LjungrennAudio/ryomodular.com_vc-seq/README.md

# ryomodular.com_vc-seq
 yup - here he is, he's got his own repo! it's the vc-seq!

240901254

mostly just a repo to hold the documentation relating to this module by ro modular.
