LjungrennAudio/ryomodular.com_vc-seq/docs/RYO_VC-Seq_Spec_Sheet.pdf

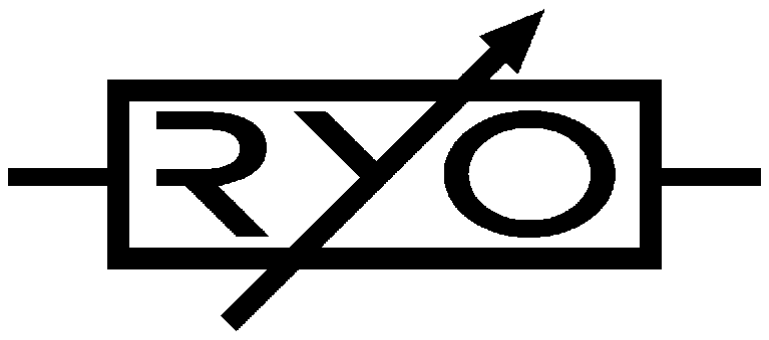
[picture p3: figure]

LjunggrenAudio RYO VC Sequencer: Compact 8-step Voltage Controlled Sequencer

Dimensions
Height: | 3U (128.5mm)
Width: | 10HP (50.50mm)
Depth: | 42mm (with power cable attached)
Weight: | 125g (approx w/cable)

Current consumption
+12V rail | 22mA (version 1.2 28mA)
-12V rail | 11mA
+5V rail | no +5V supply required

Basic specifications
total frequency controllable range | dc to 100+ kHz
max input signal | 0V to +10V
max output signal/audio signal | 10Vpp (-5V to +5V)
Max gain: | n/a

Nominal impedances
Audio signal input: | 100k ohm
Audio Signal output: | in loop compensated
CV input: | n/a
