LjungrennAudio/ryomodular.com_vc-seq/docs/vc seq pcb 1 schematic.png

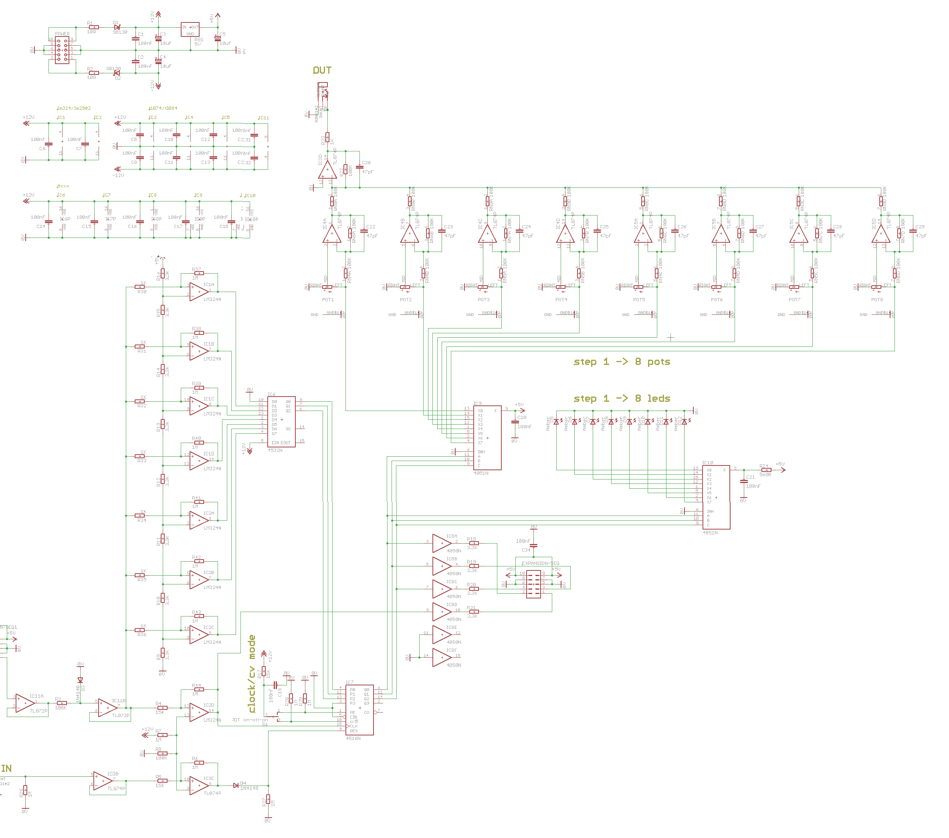
docs/vc seq pcb 1 schematic.png
