LjungrennAudio/ryomodular.com_vc-seq/docs/vc seq pcb 2 schematic.png

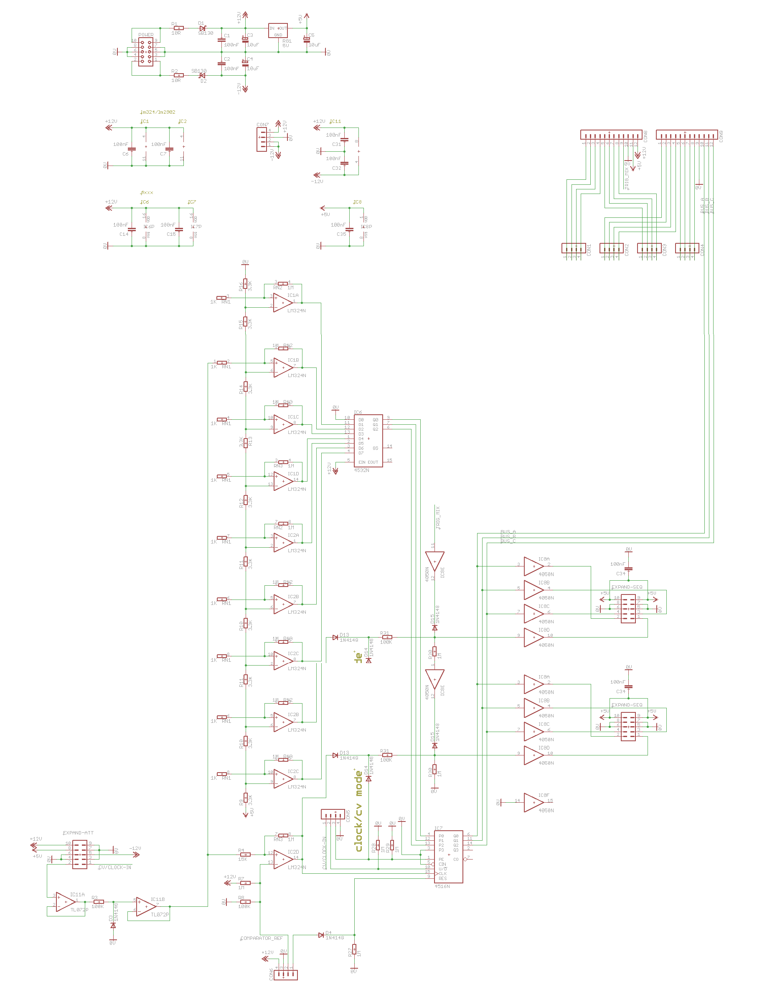
docs/vc seq pcb 2 schematic.png
