LjungrennAudio/ryomodular.com_vc-seq/docs/vc seq pcb 3 schematic.png

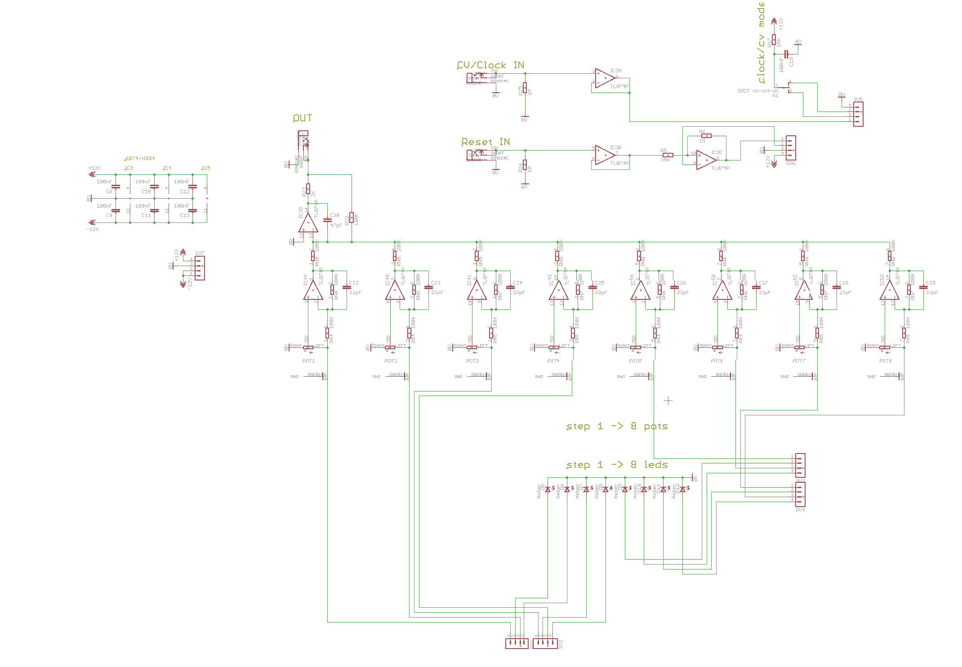
docs/vc seq pcb 3 schematic.png
