LjungrennAudio/ryomodular.com_vc-seq/docs/VC Sequencer 1.5 Schematic.gif

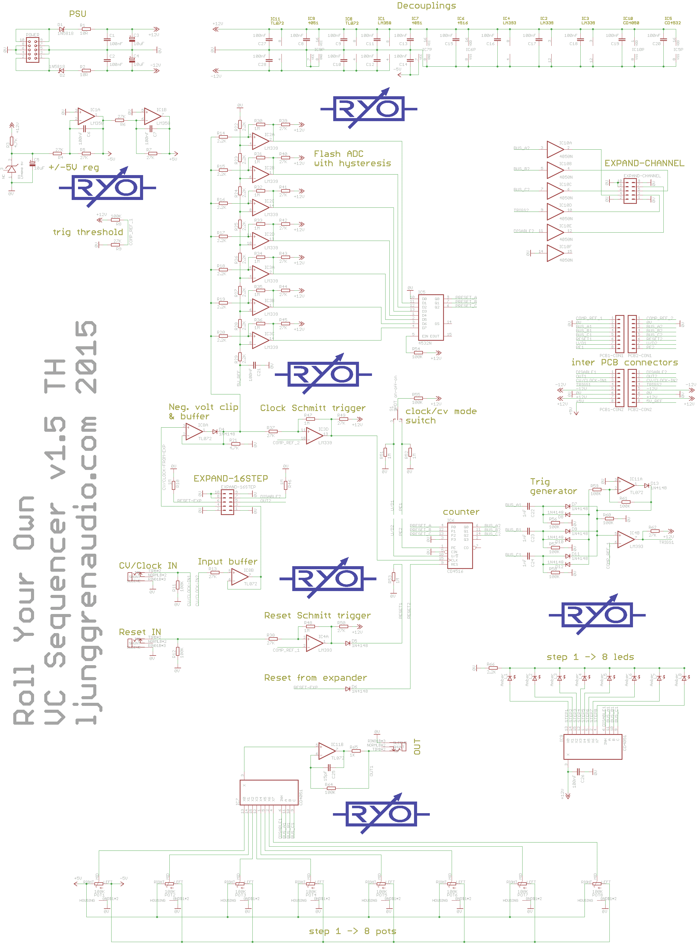
docs/VC Sequencer 1.5 Schematic.gif
