LjungrennAudio/ryomodular.com_vc-seq/docs/RYO_VC-Seq_Assembly_Guide.pdf

# Ljunggren Audio Roll Your Own

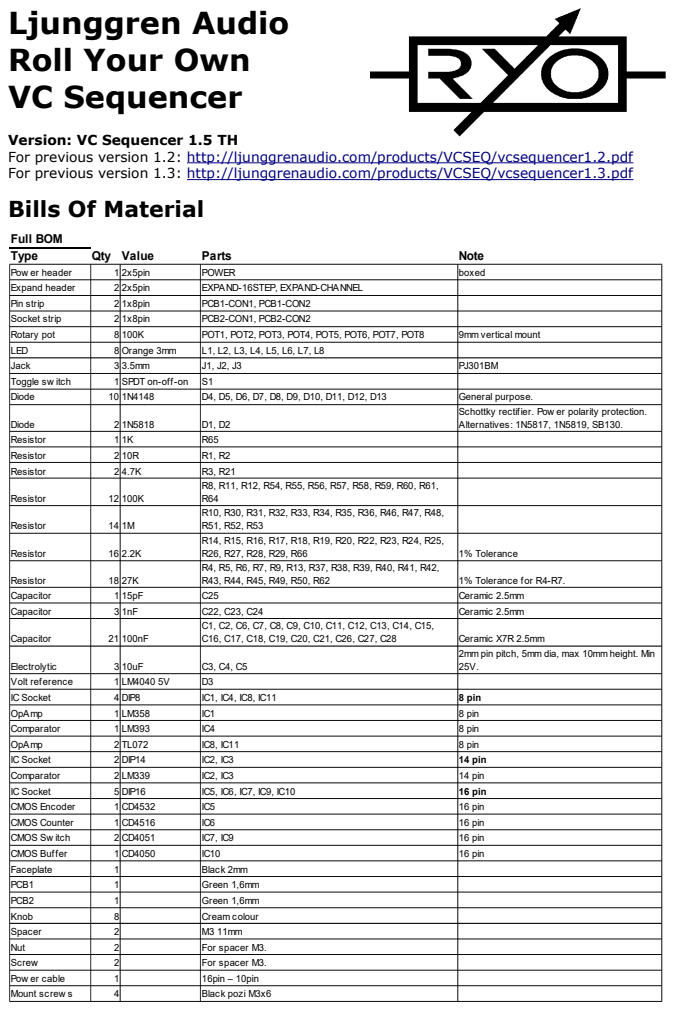
[picture p8: page 1]

Version: VC Sequencer 1.5 TH
For previous version 1.2: http://ljunggrenaudio.com/products/VCSEQ/vcsequencer1.2.pdf
For previous version 1.3: http://ljunggrenaudio.com/products/VCSEQ/vcsequencer1.3.pdf
Bills Of Material

Schottky rectifier. Pow er polarity protection.
Alternatives: 1N5817, 1N5819, SB130.

2mm pin pitch, 5mm dia, max 10mm height. Min

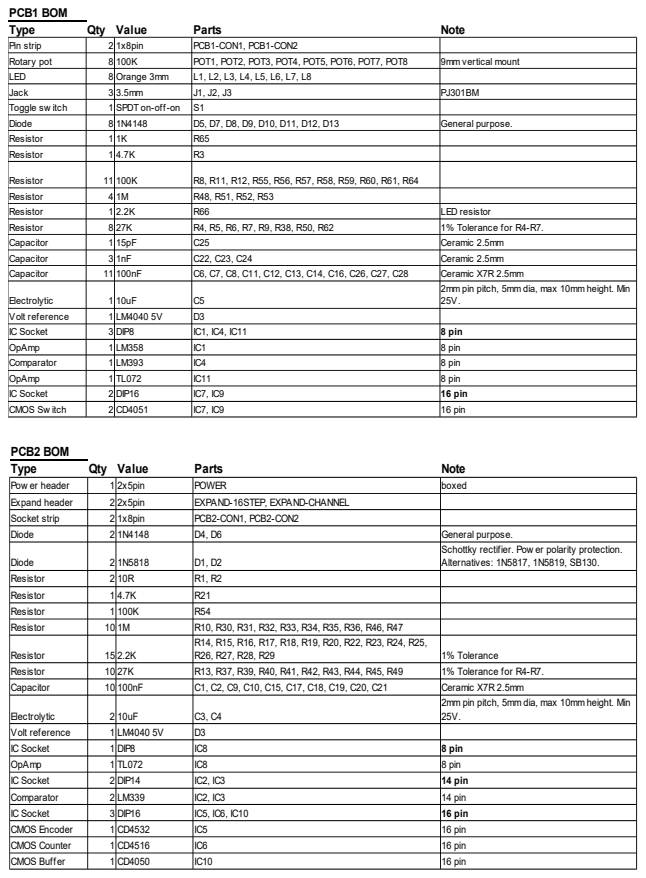
[picture p9: page 2]

2mm pin pitch, 5mm dia, max 10mm height. Min

Schottky rectifier. Pow er polarity protection.
Alternatives: 1N5817, 1N5819, SB130.

## Assembly instructions

We start with PCB2.

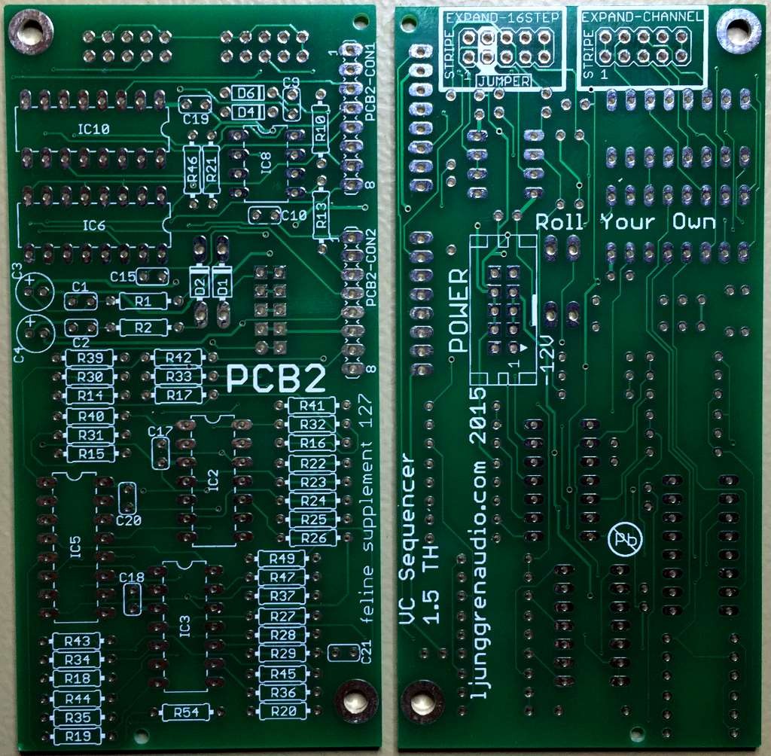
[picture p10: figure]

Empty PCB2 top & bottom.

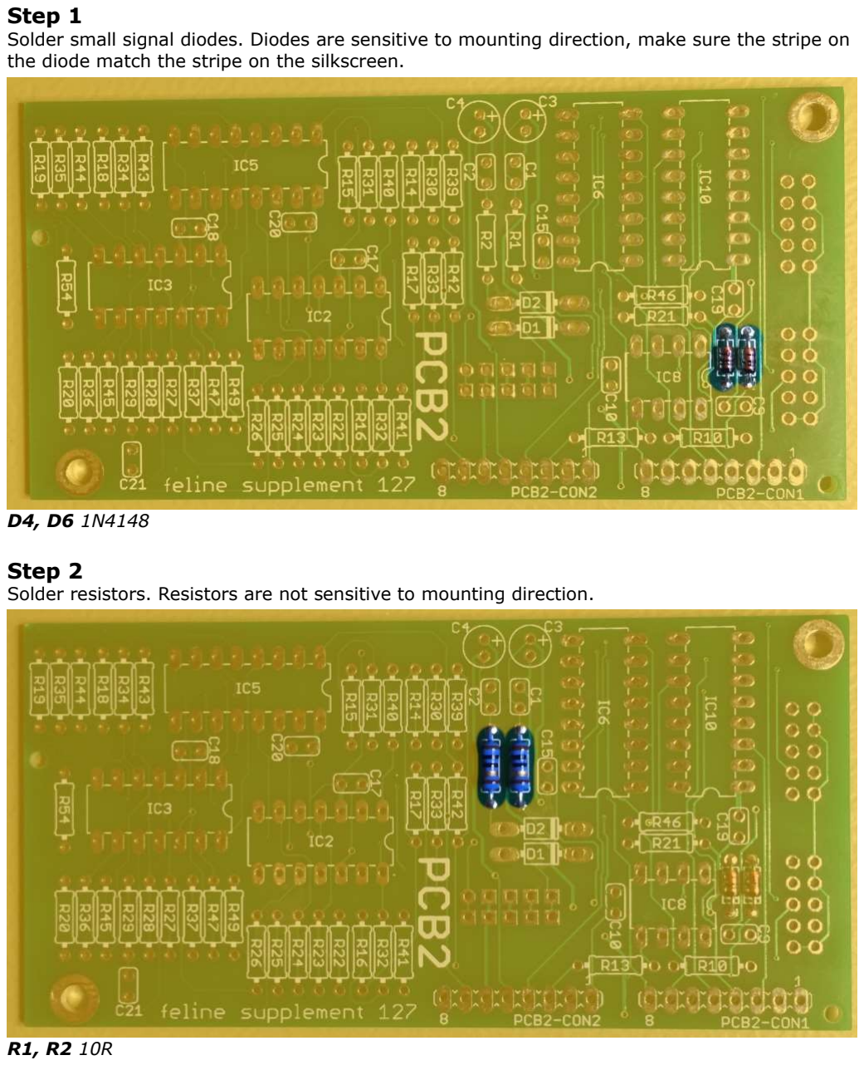
[picture p11: page 4]

### Step 1

Solder small signal diodes. Diodes are sensitive to mounting direction, make sure the stripe on the diode match the stripe on the silkscreen.

D4, D6 1N4148

### Step 2

Solder resistors. Resistors are not sensitive to mounting direction.

R1, R2 10R

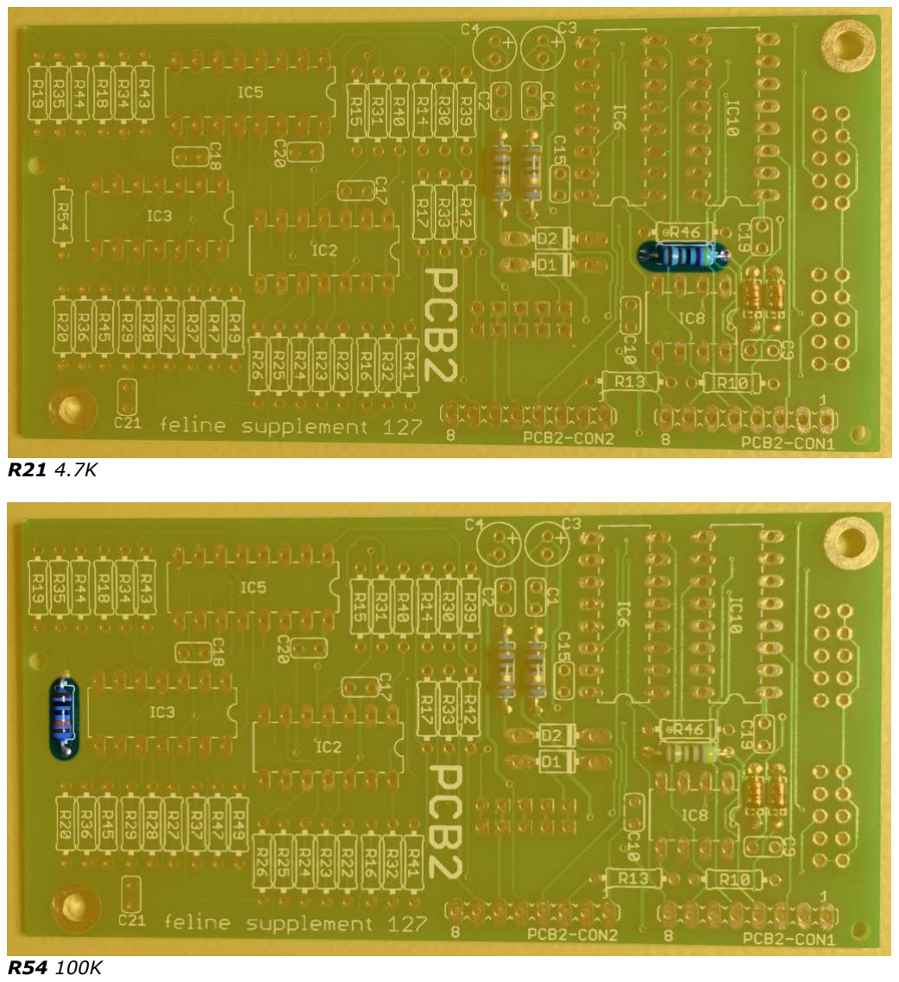
[picture p12: page 5]

R21 4.7K

R54 100K

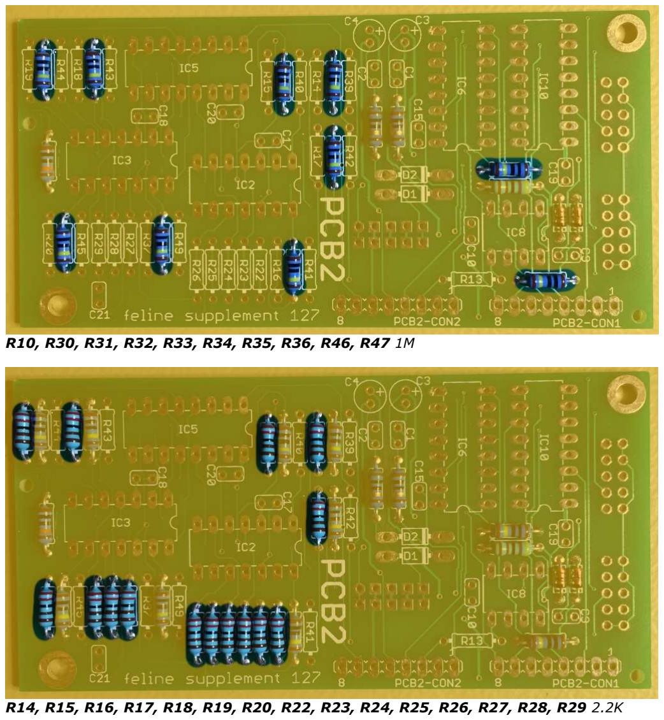
[picture p13: page 6]

R10, R30, R31, R32, R33, R34, R35, R36, R46, R47 1M

R14, R15, R16, R17, R18, R19, R20, R22, R23, R24, R25, R26, R27, R28, R29 2.2K

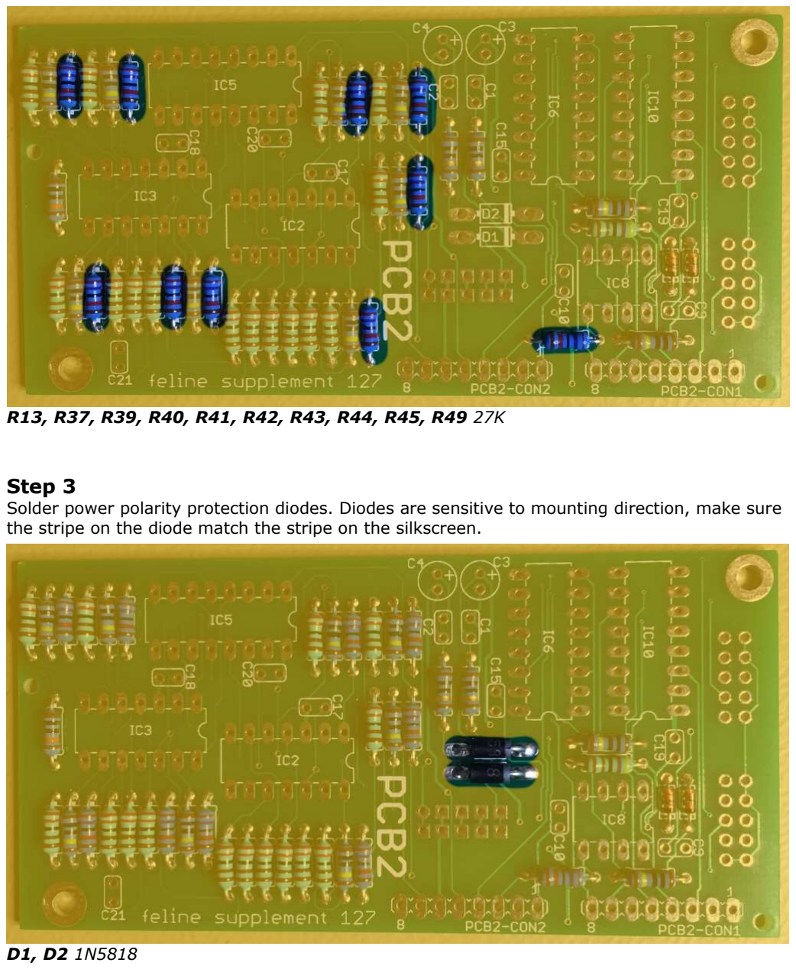
[picture p14: page 7]

R13, R37, R39, R40, R41, R42, R43, R44, R45, R49 27K

### Step 3

Solder power polarity protection diodes. Diodes are sensitive to mounting direction, make sure the stripe on the diode match the stripe on the silkscreen.

D1, D2 1N5818

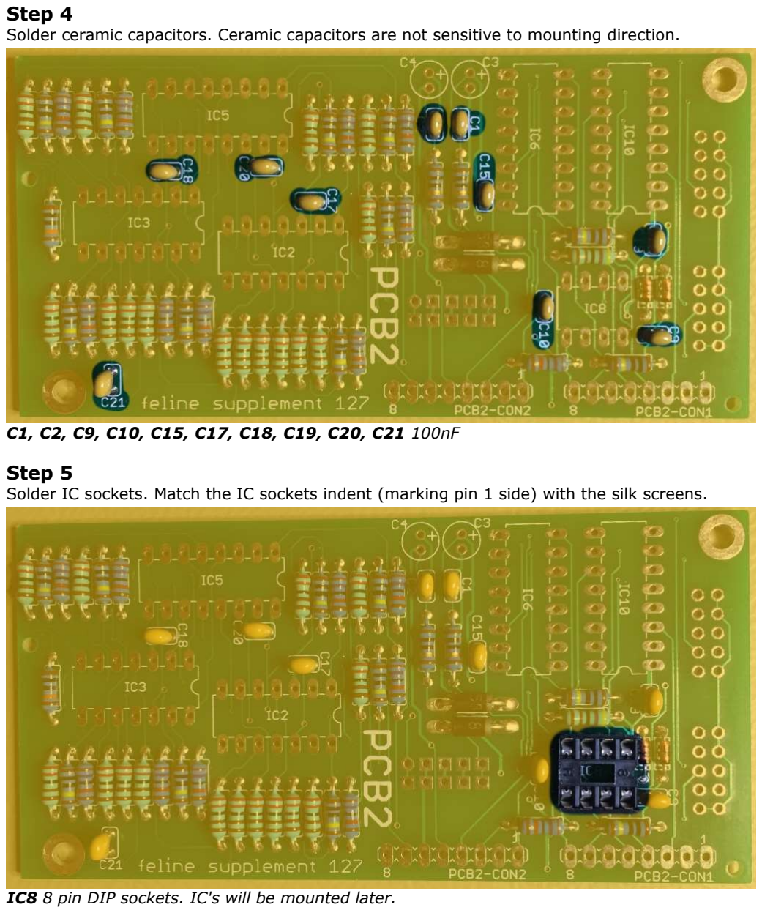
[picture p15: page 8]

### Step 4

Solder ceramic capacitors. Ceramic capacitors are not sensitive to mounting direction.

C1, C2, C9, C10, C15, C17, C18, C19, C20, C21 100nF

### Step 5

Solder IC sockets. Match the IC sockets indent (marking pin 1 side) with the silk screens.

IC8 8 pin DIP sockets. IC's will be mounted later.

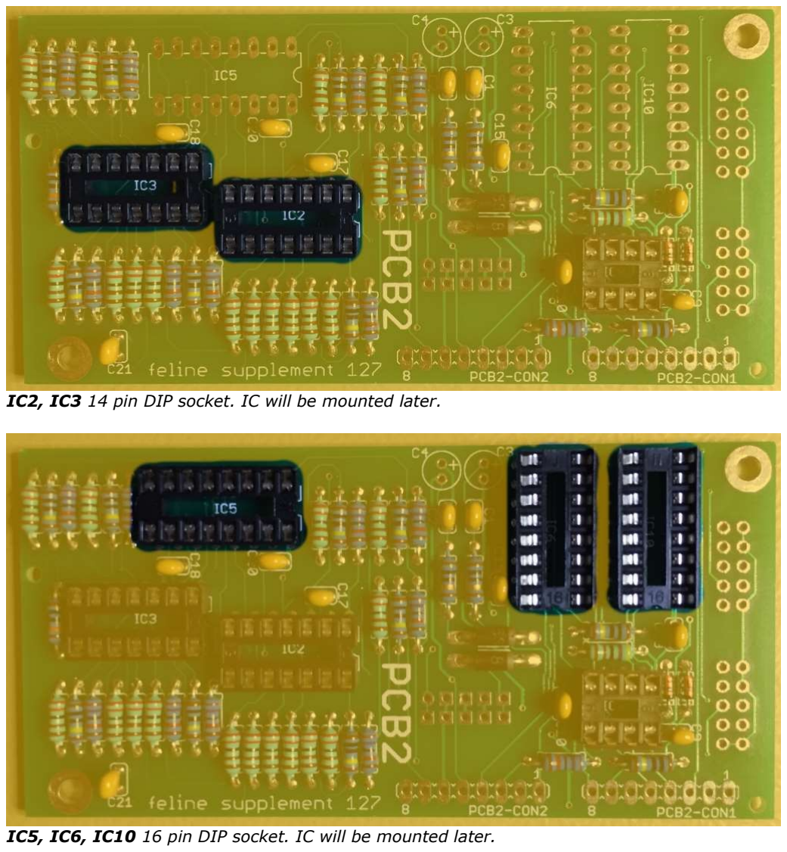
[picture p16: page 9]

IC2, IC3 14 pin DIP socket. IC will be mounted later.

IC5, IC6, IC10 16 pin DIP socket. IC will be mounted later.

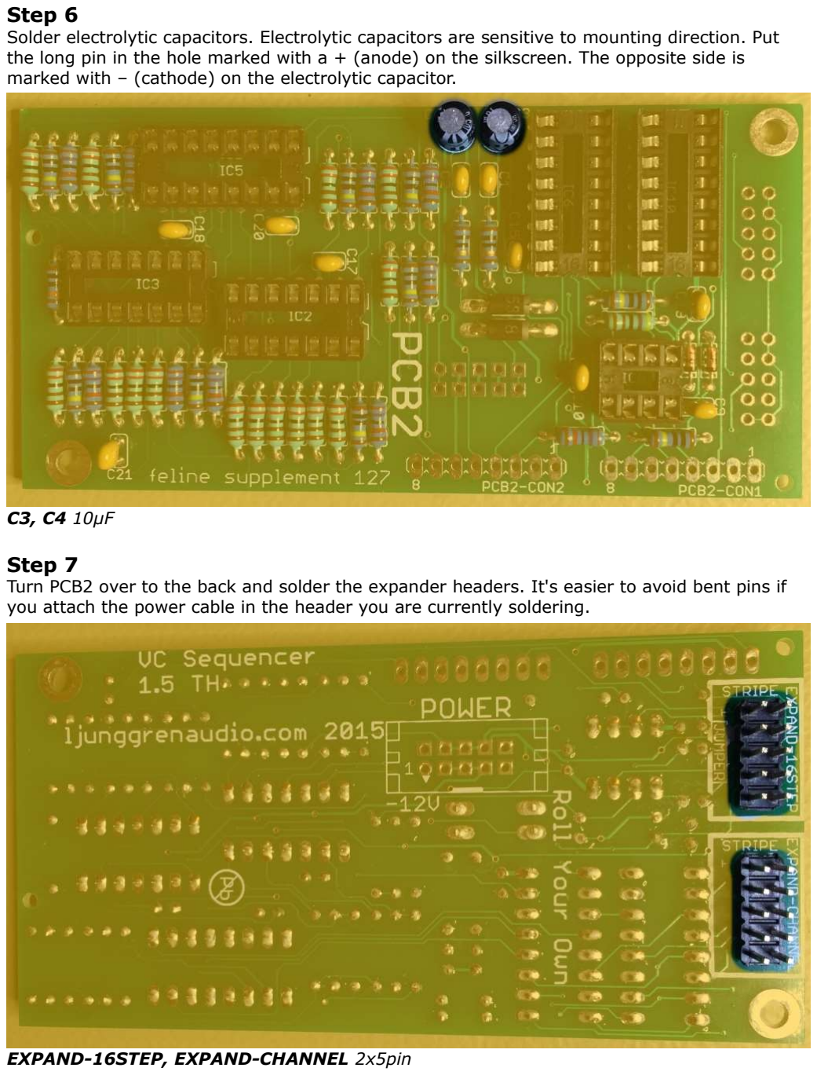
[picture p17: page 10]

### Step 6

Solder electrolytic capacitors. Electrolytic capacitors are sensitive to mounting direction. Put the long pin in the hole marked with a + (anode) on the silkscreen. The opposite side is marked with – (cathode) on the electrolytic capacitor.

C3, C4 10µF

### Step 7

Turn PCB2 over to the back and solder the expander headers. It's easier to avoid bent pins if you attach the power cable in the header you are currently soldering.

EXPAND-16STEP, EXPAND-CHANNEL 2x5pin

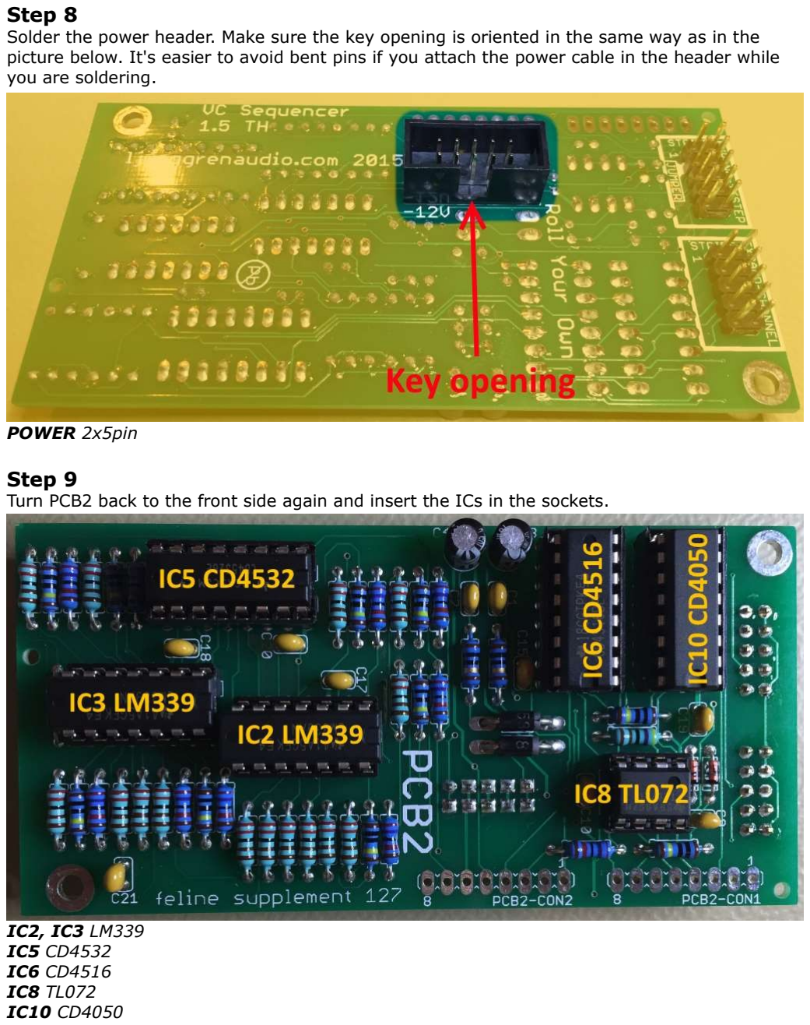
[picture p18: page 11]

### Step 8

Solder the power header. Make sure the key opening is oriented in the same way as in the picture below. It's easier to avoid bent pins if you attach the power cable in the header while you are soldering.

POWER 2x5pin

### Step 9

Turn PCB2 back to the front side again and insert the ICs in the sockets.

IC2, IC3 LM339
IC5 CD4532
IC6 CD4516
IC8 TL072
IC10 CD4050

### Step 10

Leave PCB2 on the side with PCB2-CON1 and PCB2-CON2 not soldered. Now it's time for PCB1.

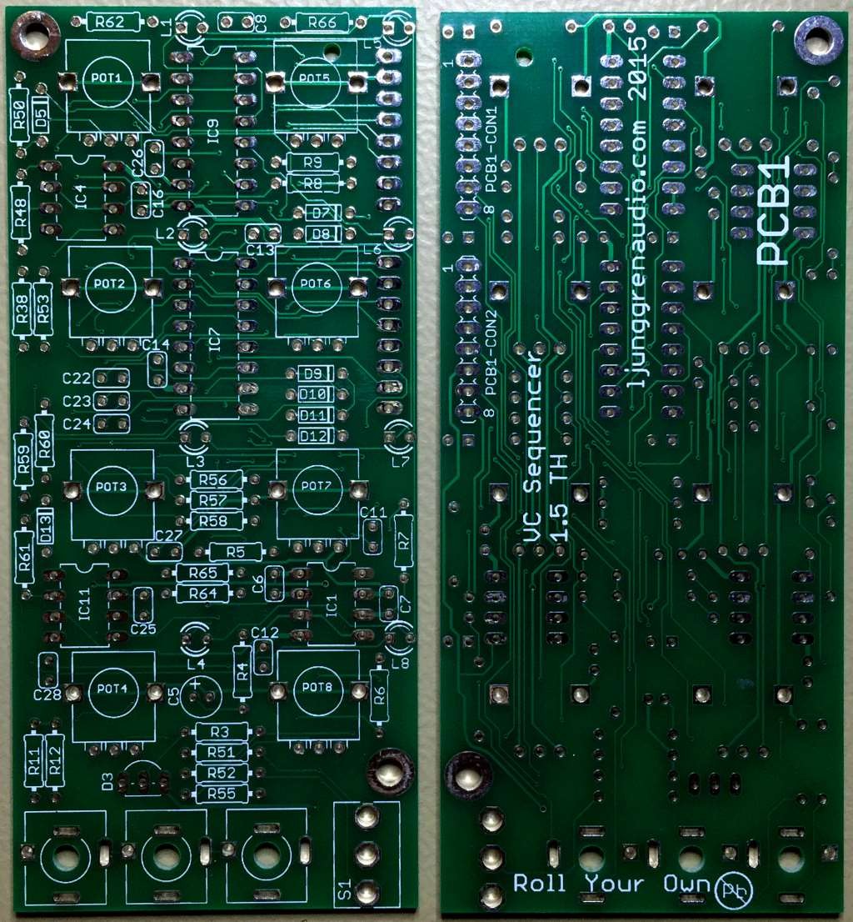
[picture p19: figure]

Empty PCB1 top & bottom.

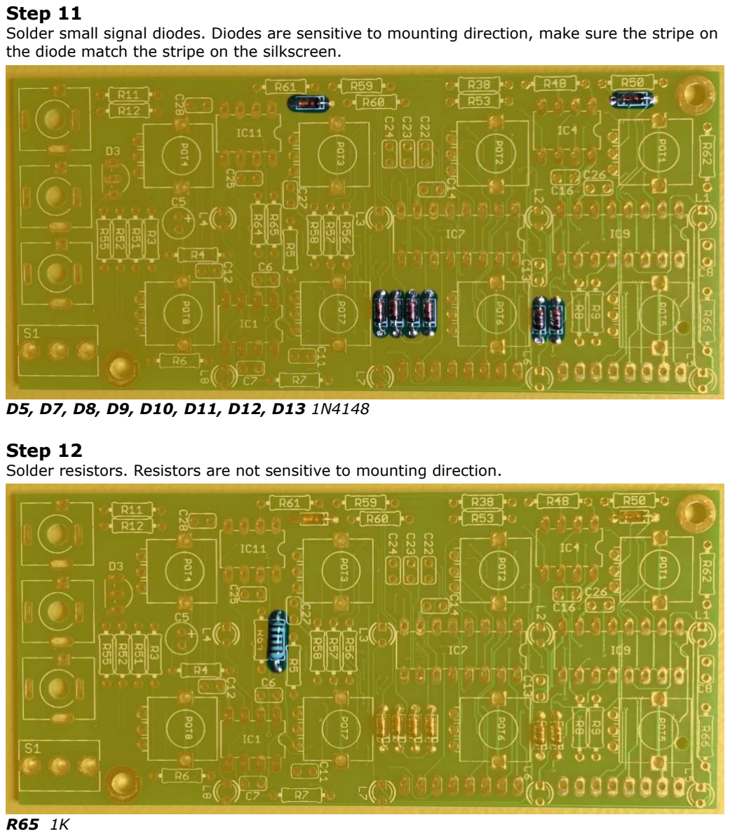
[picture p20: page 13]

### Step 11

Solder small signal diodes. Diodes are sensitive to mounting direction, make sure the stripe on the diode match the stripe on the silkscreen.

D5, D7, D8, D9, D10, D11, D12, D13 1N4148

### Step 12

Solder resistors. Resistors are not sensitive to mounting direction.

R65 1K

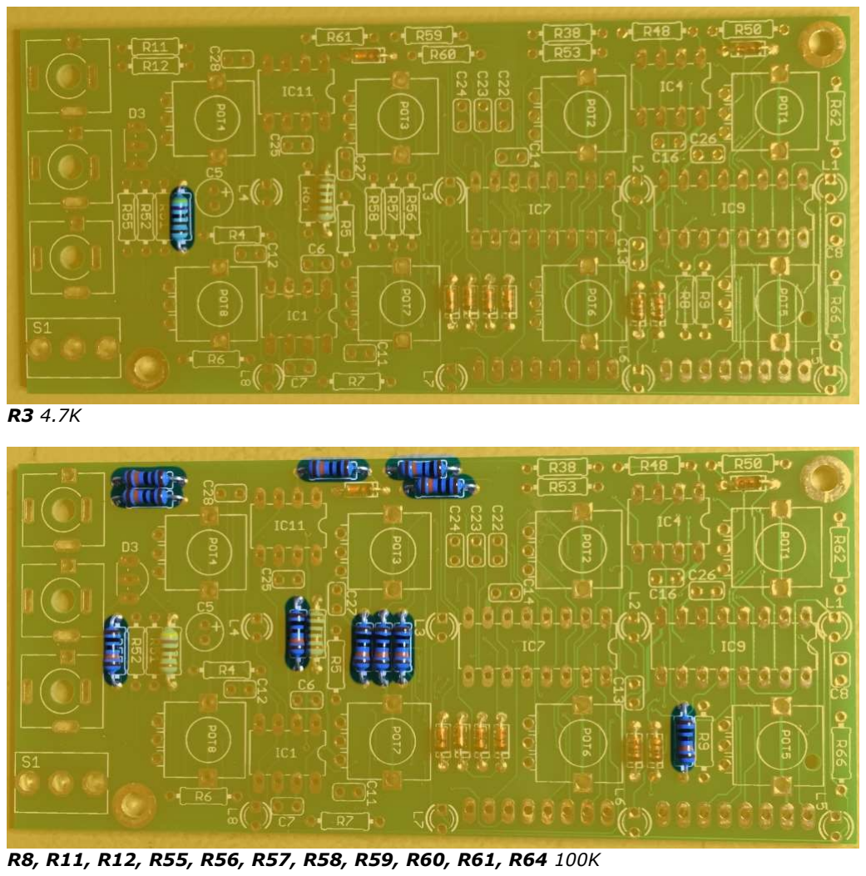
[picture p21: page 14]

R3 4.7K

R8, R11, R12, R55, R56, R57, R58, R59, R60, R61, R64 100K

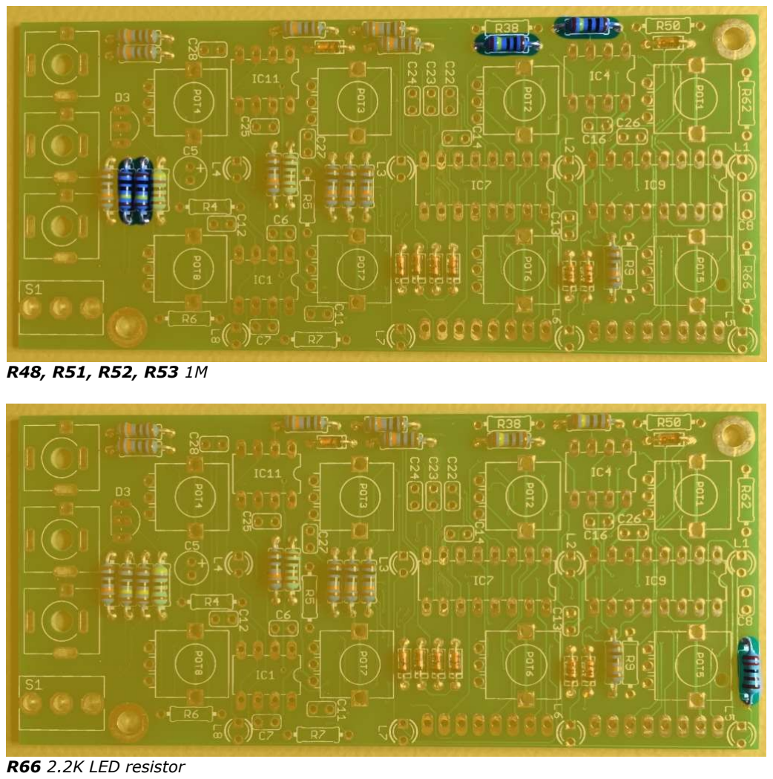
[picture p22: page 15]

R48, R51, R52, R53 1M

R66 2.2K LED resistor

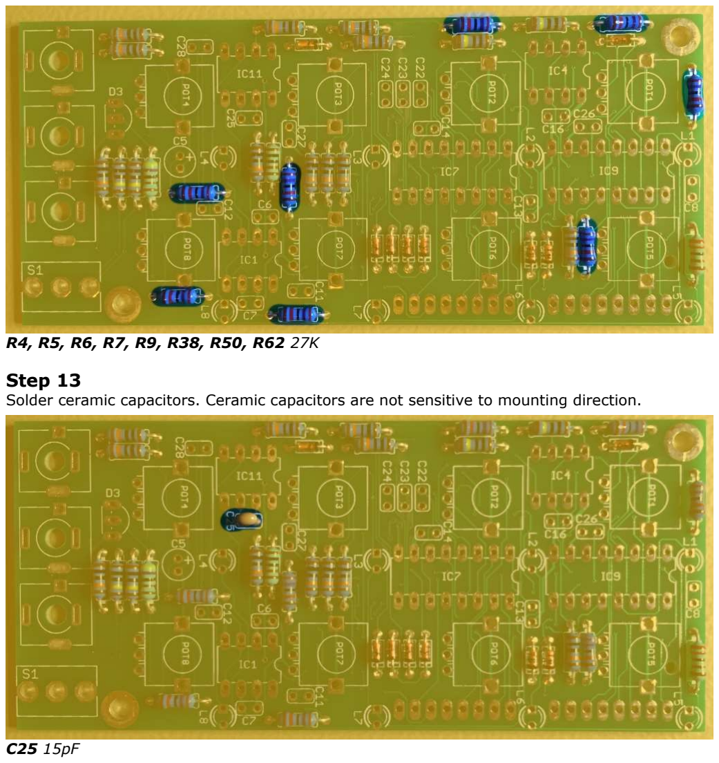
[picture p23: page 16]

R4, R5, R6, R7, R9, R38, R50, R62 27K

### Step 13

Solder ceramic capacitors. Ceramic capacitors are not sensitive to mounting direction.

C25 15pF

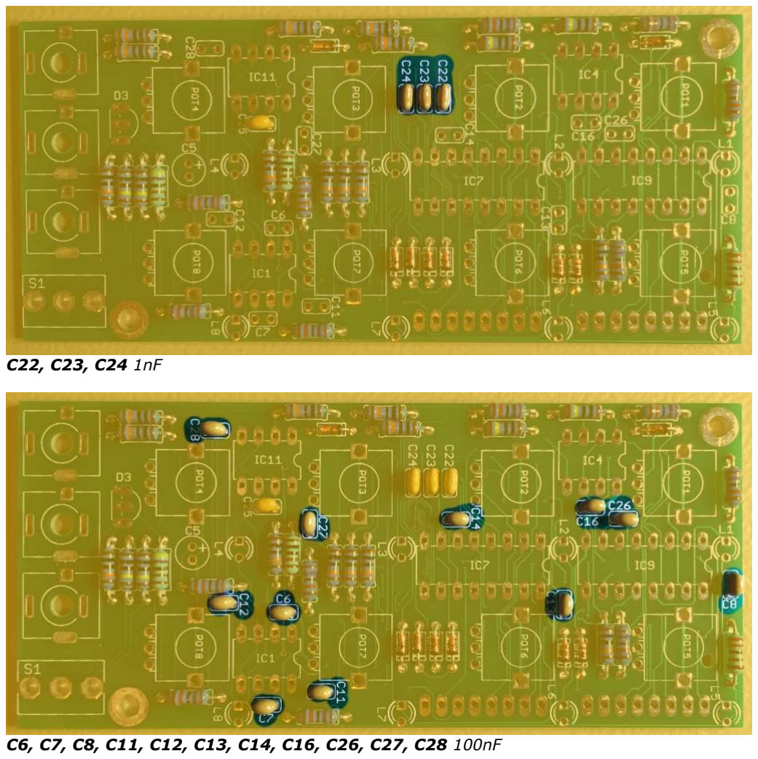
[picture p24: page 17]

C22, C23, C24 1nF

C6, C7, C8, C11, C12, C13, C14, C16, C26, C27, C28 100nF

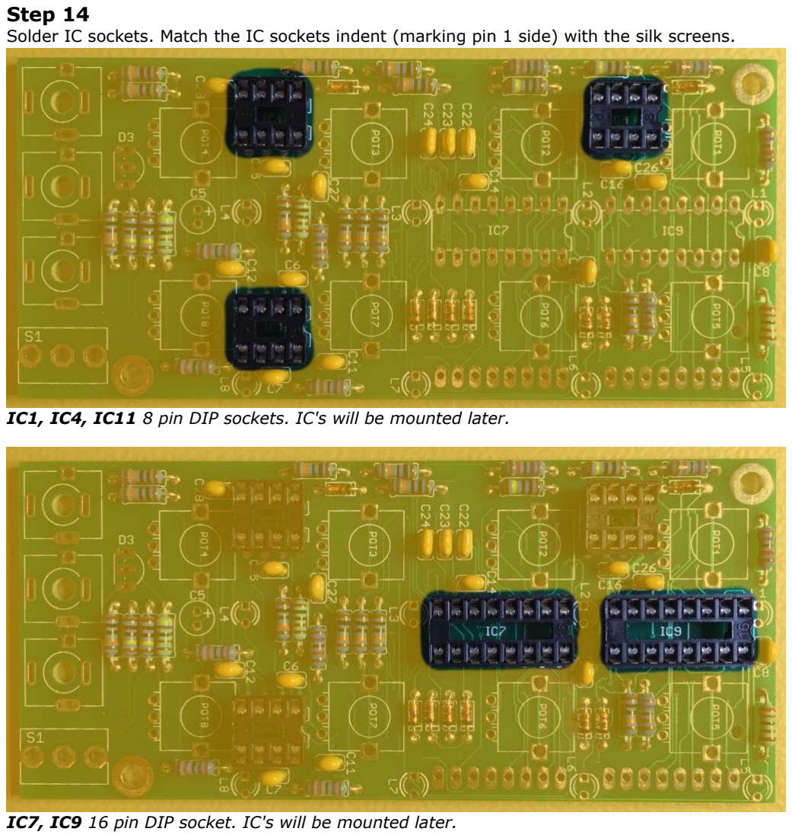
[picture p25: page 18]

### Step 14

Solder IC sockets. Match the IC sockets indent (marking pin 1 side) with the silk screens.

IC1, IC4, IC11 8 pin DIP sockets. IC's will be mounted later.

IC7, IC9 16 pin DIP socket. IC's will be mounted later.

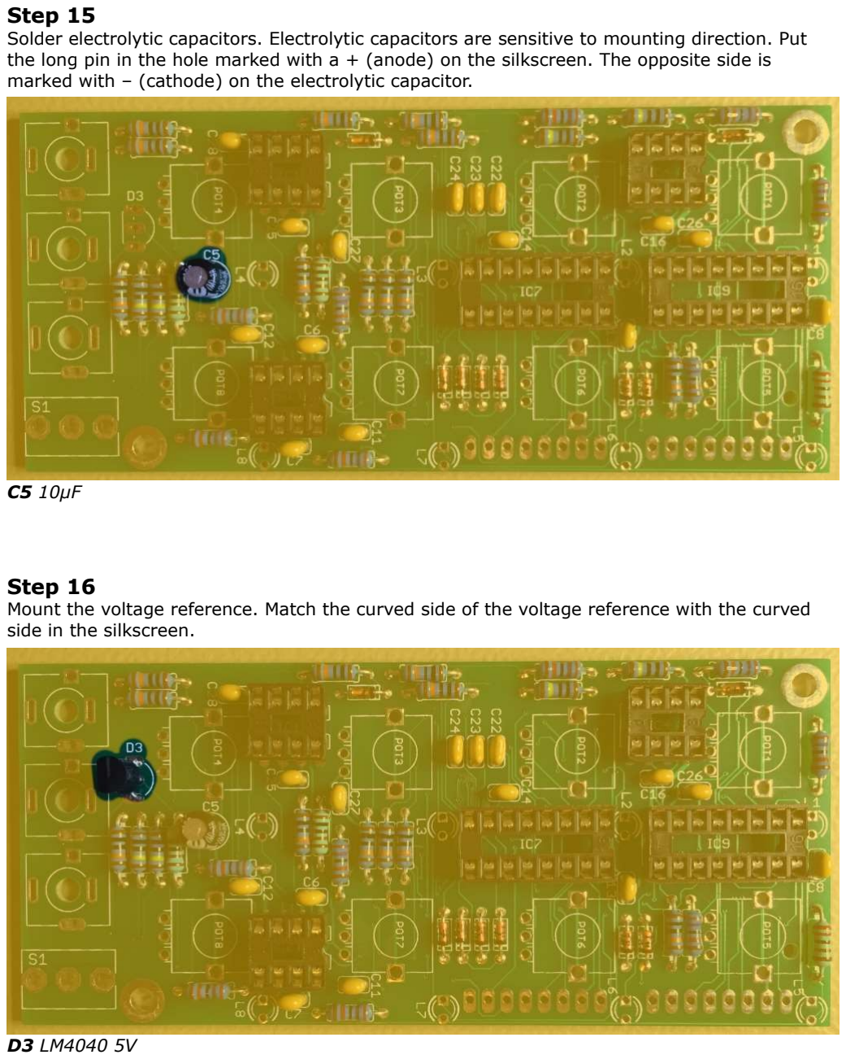
[picture p26: page 19]

### Step 15

Solder electrolytic capacitors. Electrolytic capacitors are sensitive to mounting direction. Put the long pin in the hole marked with a + (anode) on the silkscreen. The opposite side is marked with – (cathode) on the electrolytic capacitor.

C5 10µF

### Step 16

Mount the voltage reference. Match the curved side of the voltage reference with the curved side in the silkscreen.

D3 LM4040 5V

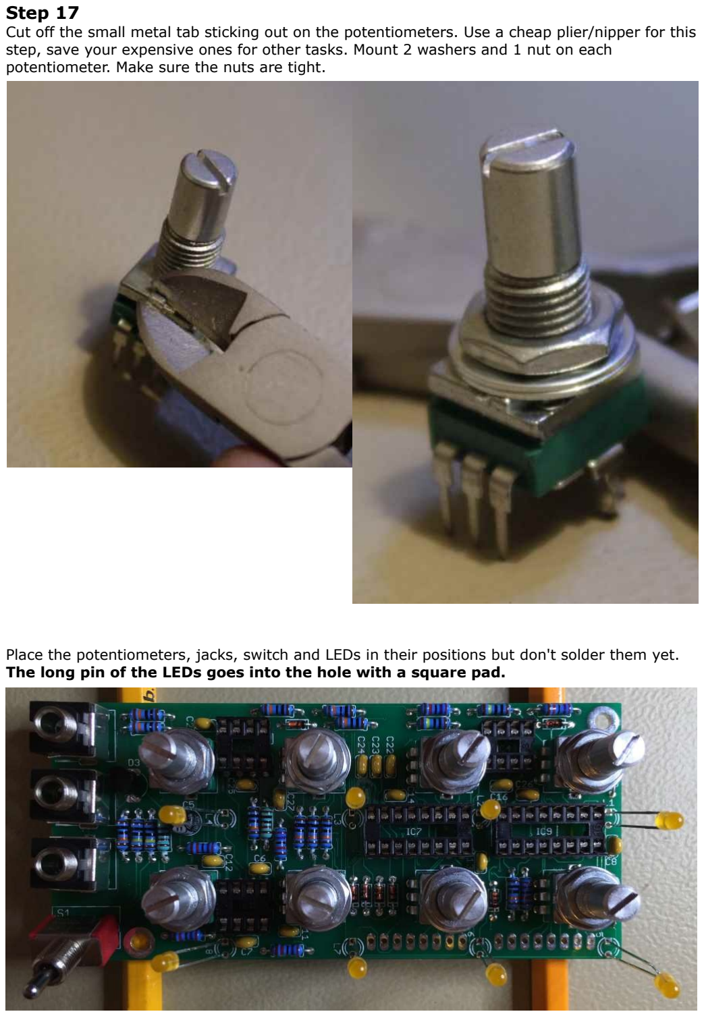
[picture p27: page 20]

### Step 17

Cut off the small metal tab sticking out on the potentiometers. Use a cheap plier/nipper for this step, save your expensive ones for other tasks. Mount 2 washers and 1 nut on each potentiometer. Make sure the nuts are tight.

Place the potentiometers, jacks, switch and LEDs in their positions but don't solder them yet. The long pin of the LEDs goes into the hole with a square pad.

Place the front panel on top and add 1 washer and 1 nut to each potentiometer, jack and the switch. Use a socket wrench to avoid scratching of the frontplate.

The switch have bigger pad holes in version 1.5 to allow more different switches to fit but it also means you need to be extra careful to make sure the switch is aligned straight.

Turn it upside down and make sure the LEDs go into their respective panel hole properly.

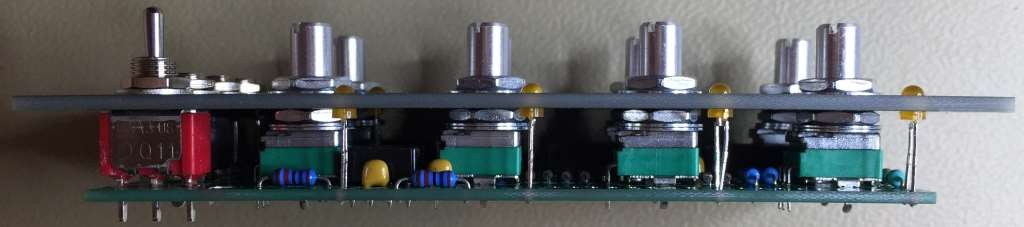
[picture p28: figure]

Now you solder all panel components in place.

### Step 18

Remove the front panel again. Insert the ICs in the sockets.

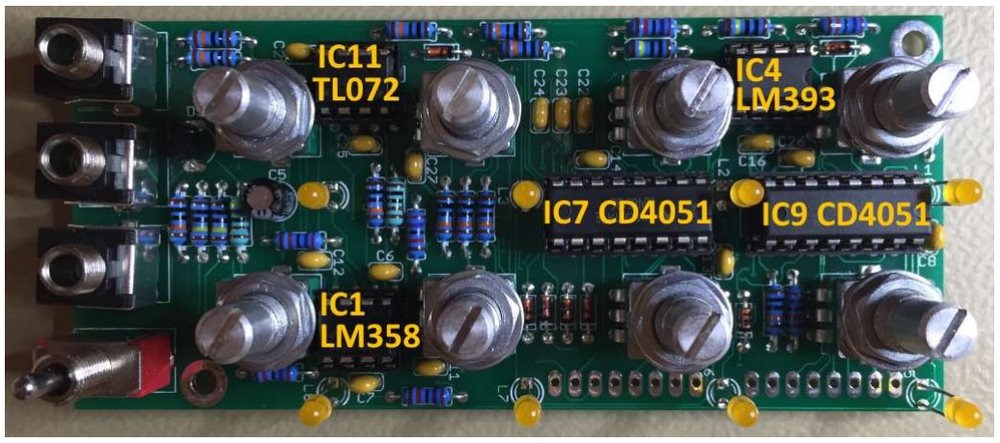
[picture p29: figure]

IC1 LM358
IC4 LM393
IC7, IC9 CD4051
IC11 TL072

### Step 19

Mount the spacers with the nuts on PCB1.

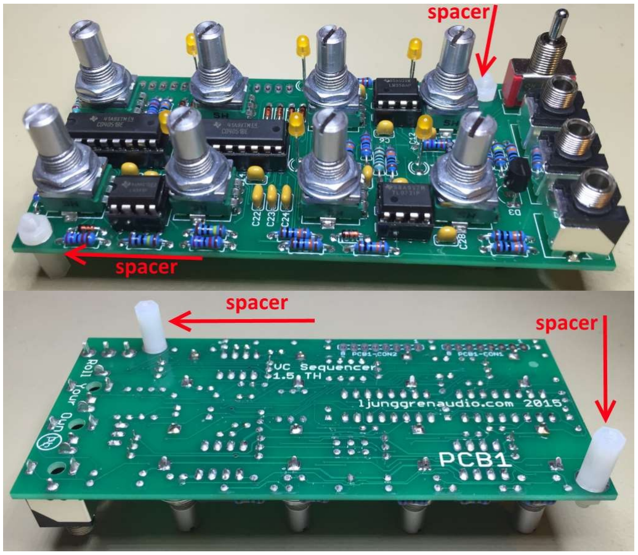
[picture p30: figure]

### Step 20

Put the pin & socket strips into each other. Place them between PCB1 and PCB2 like in the picture below. Take a firm grip with a plier around the spacers and screw the screws into place like in the picture below. It's important that the grip is firm as there is a bit of friction in this step and we don't want the nuts to loosen. If the nuts gets loose, tighten them again.

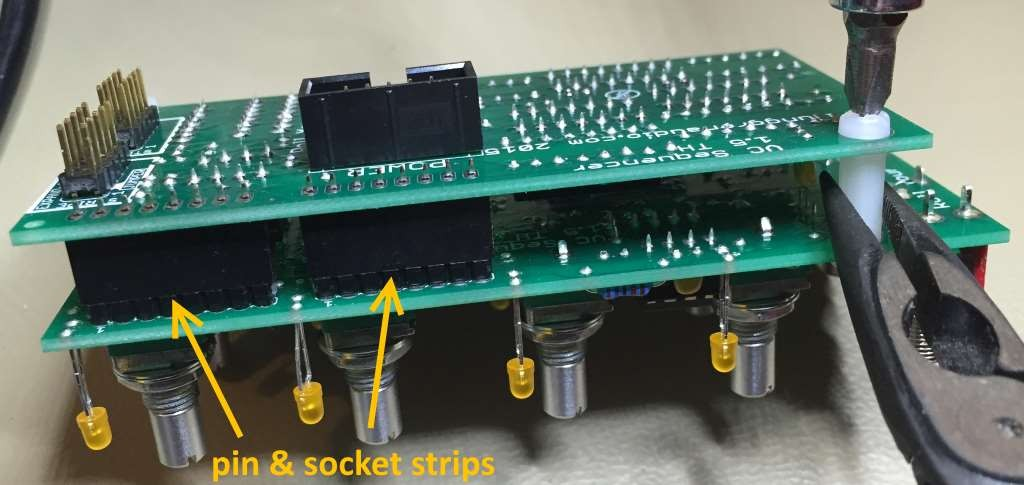
[picture p31: figure]

Solder the connectors between PCB1 & 2 in place.

### Step 21

Mount the jumper on the EXPAND-16STEP header if you aren't going to attach an expander there. Also mount the power cable on the power header. Make sure the stripe indicating pin 1 is on the same side as -12V.

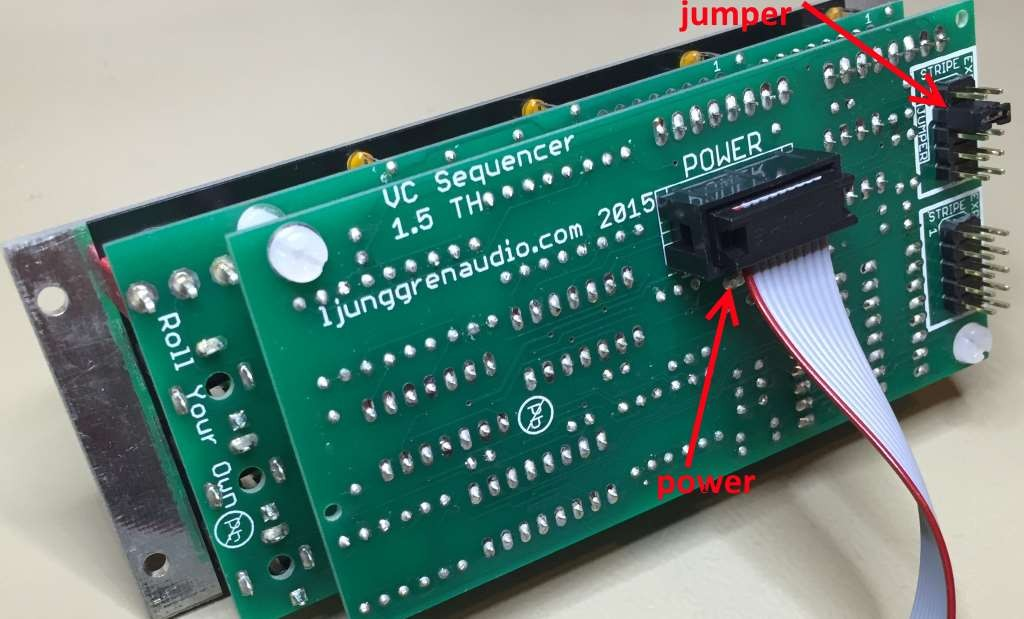
[picture p32: figure]

### Step 22

Mount the knobs.

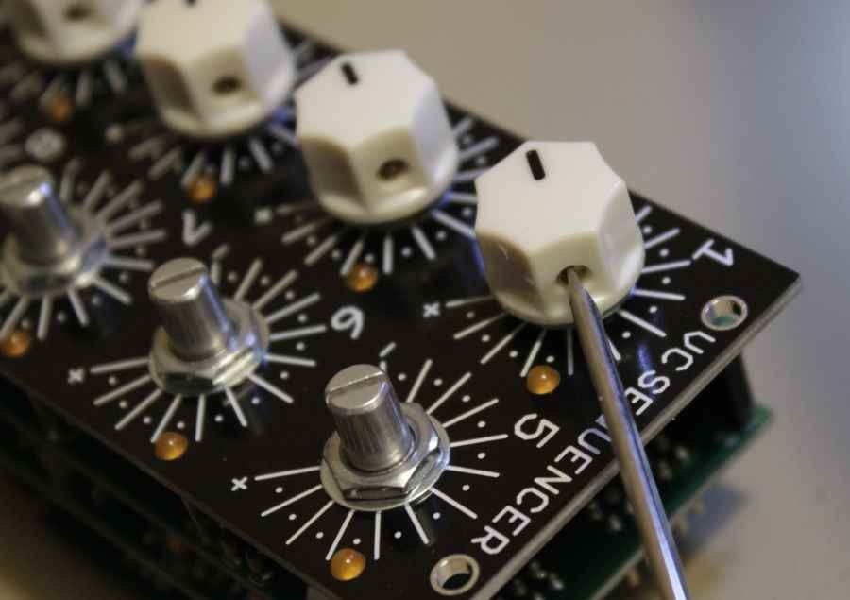
[picture p33: figure]

### Finished module!

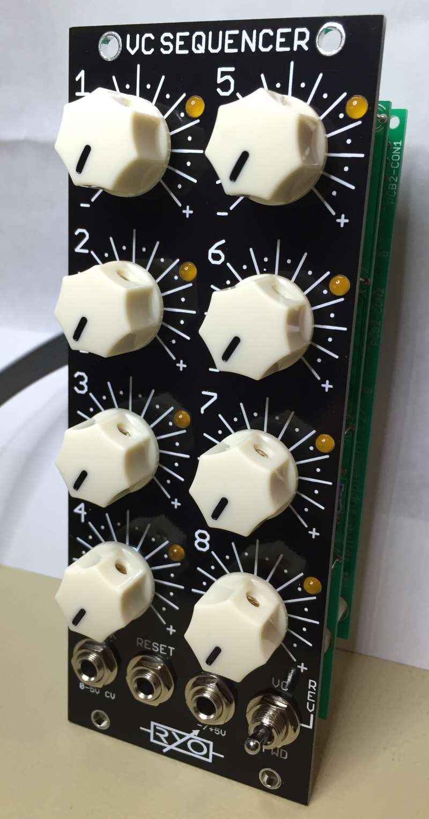
[picture p34: figure]
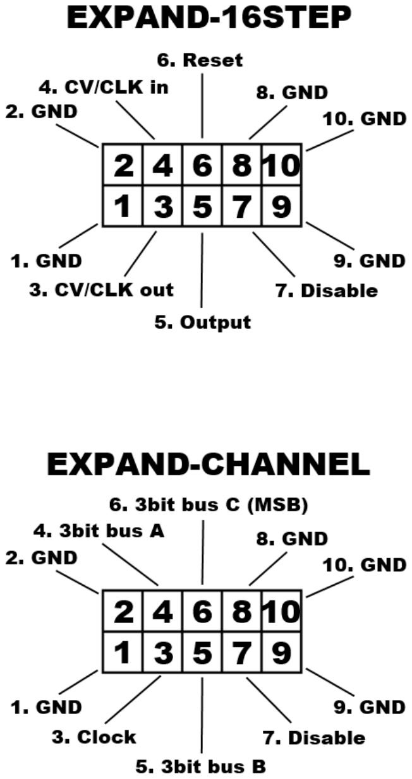
[picture p35: page 26]
