LjungrennAudio/ryomodular.com_vc-seq/build/PCB 1.5 TH.brd

## EAGLE design build/PCB 1.5 TH.brd (2024-09-06)

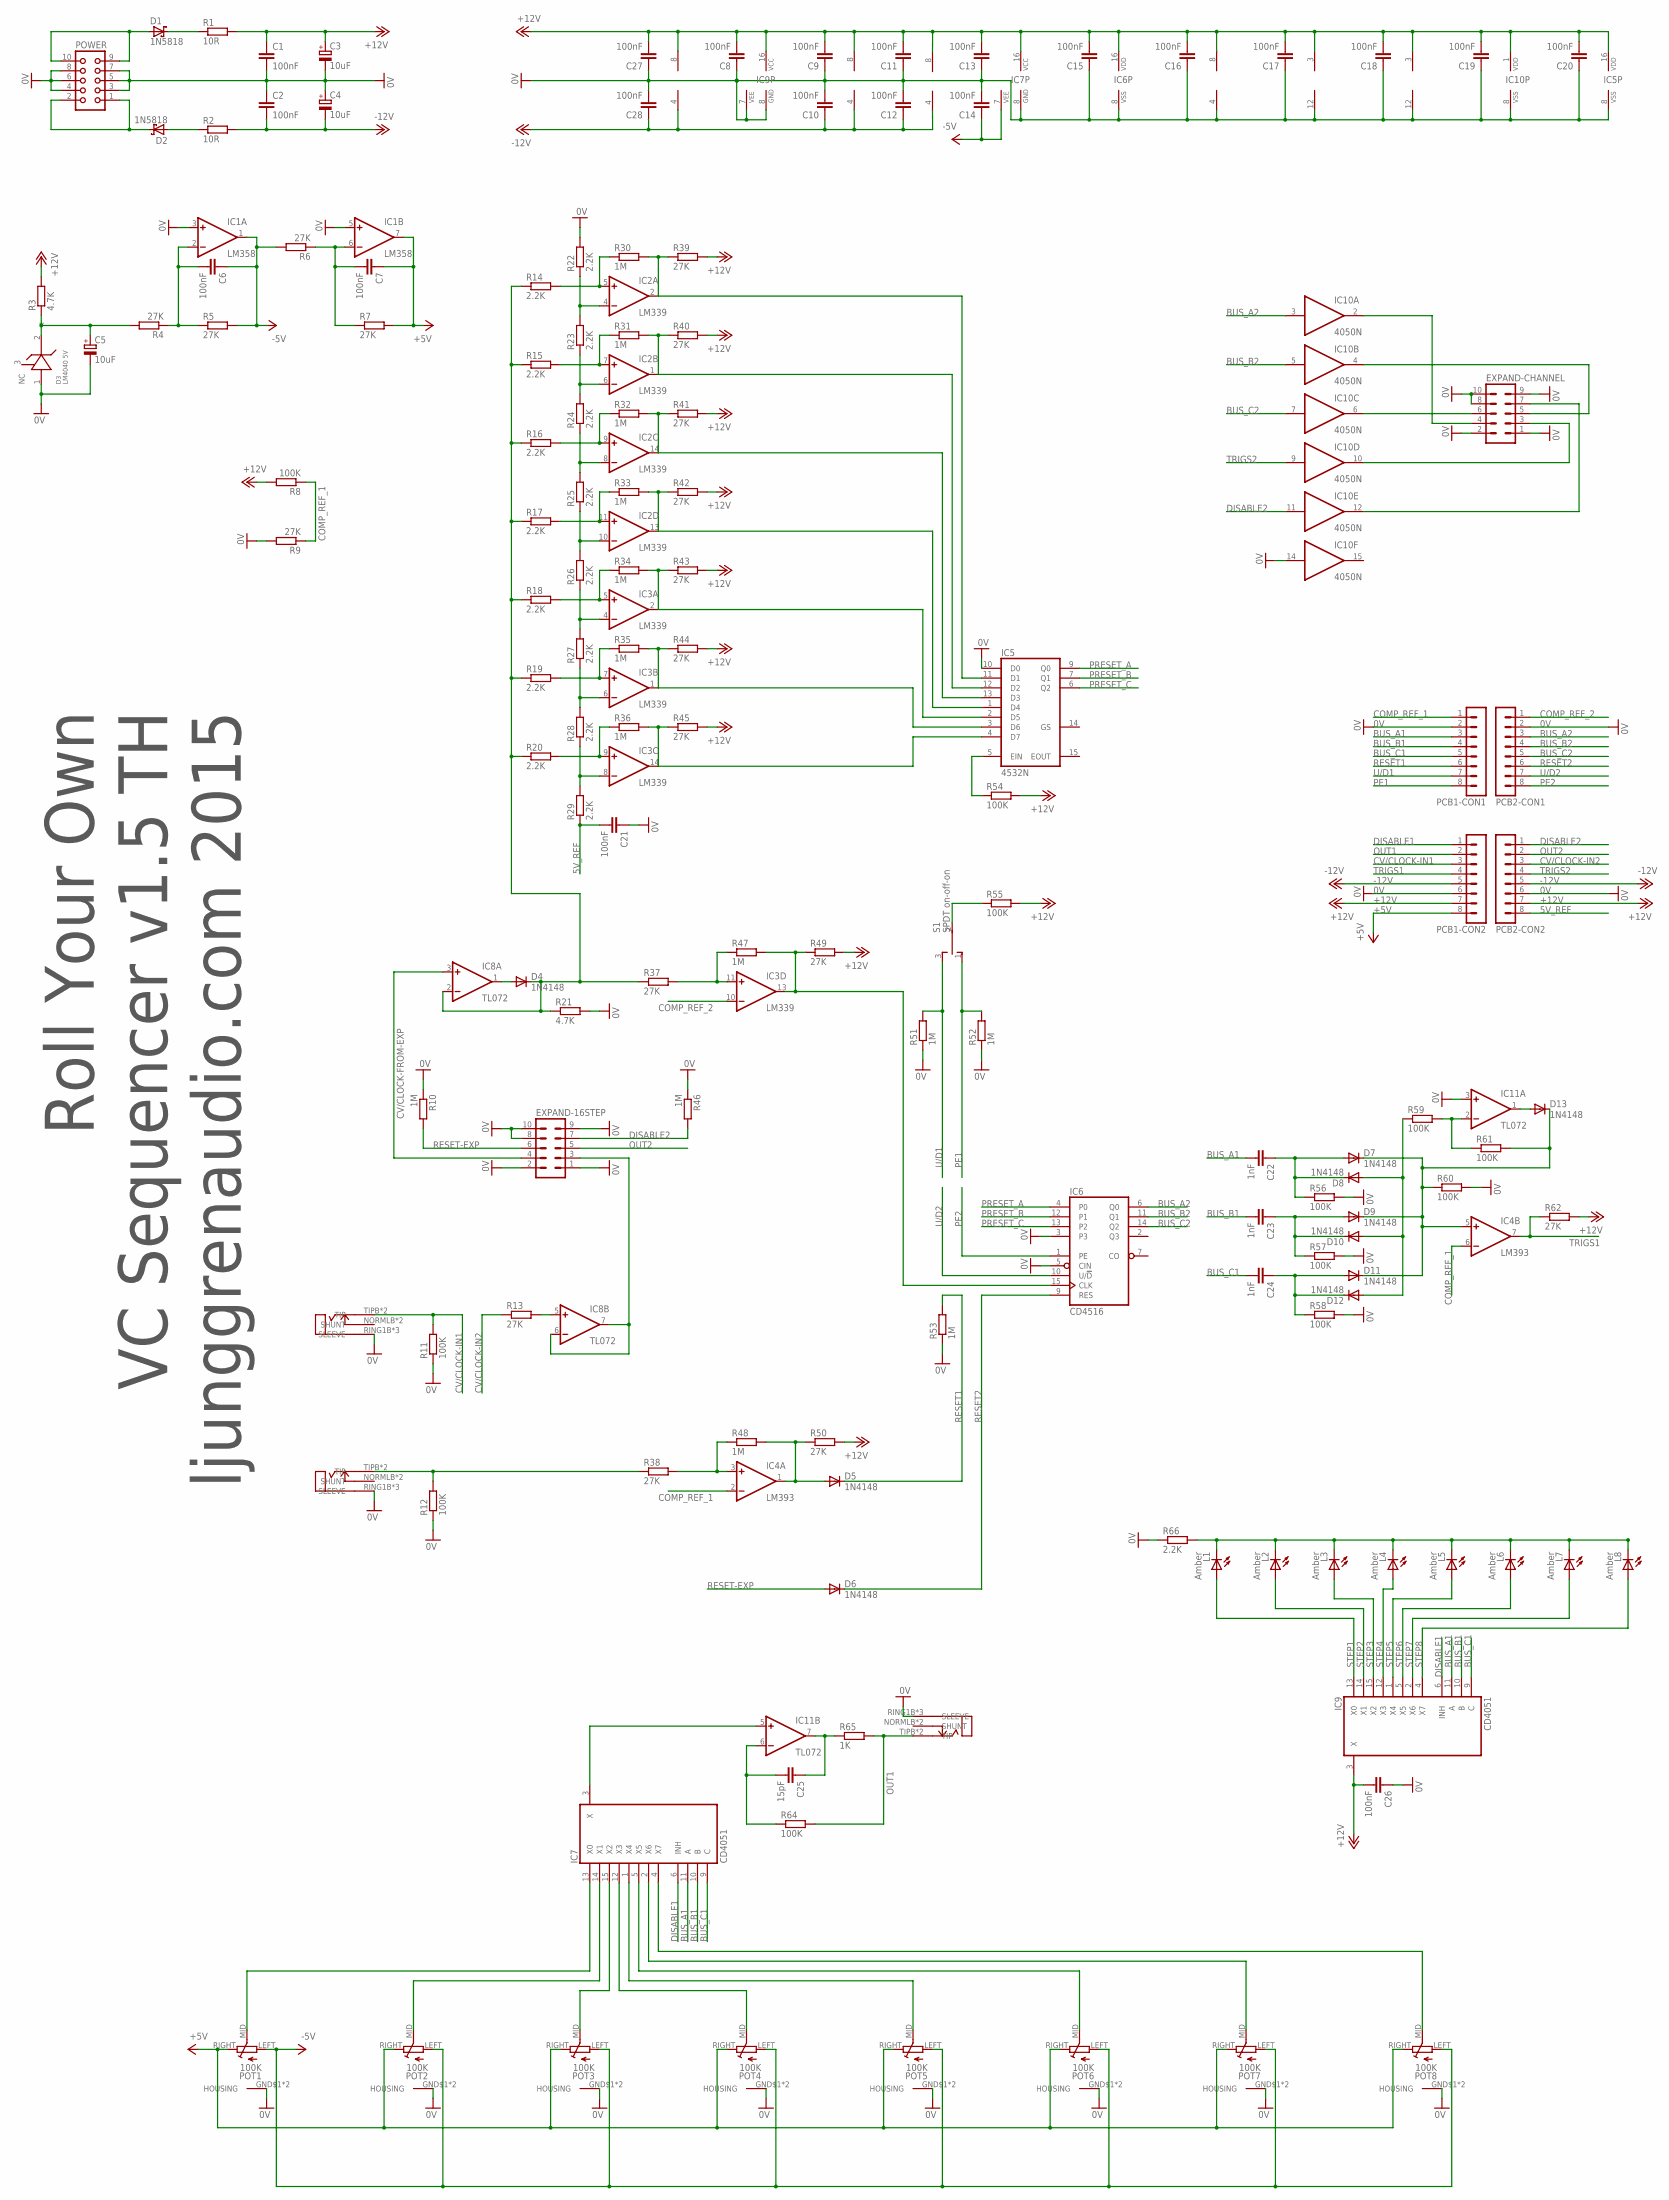
[picture p38: schematic PCB 1.5 TH.sch]

Parts:
C1, C2, C6, C7, C8, C9, C10, C11, C12, C13, C14, C15, C16, C17, C18, C19, C20, C21, C26, C27, C28: 100nF; C025-024X044
C3, C4, C5: 10uF; E2-5
C22, C23, C24: 1nF; C025-024X044
C25: 15pF; C025-024X044
CV/CLK-IN: ERTHENVAR_3.5MM_JACKSLOTS; ERTHENVAR-SLOTS
D1, D2: 1N5818; DO41-7
D3: LM4040 5V; TO92-LINE
D4, D5, D6, D7, D8, D9, D10, D11, D12, D13: 1N4148; DO35-6
EXPAND-16STEP: MA05-2
EXPAND-CHANNEL: MA05-2
IC1: LM358; DIL08
IC2, IC3: LM339; DIL14
IC4: LM393; DIL08
IC5: 4532N; DIL16
IC6: CD4516; DIL16
IC7, IC9: CD4051; DIL16
IC8, IC11: TL072; DIL08
IC10: 4050N; DIL16
L1, L2, L3, L4, L5, L6, L7, L8: Amber; LED3MM
OUT: ERTHENVAR_3.5MM_JACKSLOTS; ERTHENVAR-SLOTS
PCB1-CON1, PCB1-CON2, PCB2-CON1, PCB2-CON2: MA08-1
POT1, POT2, POT3, POT4, POT5, POT6, POT7, POT8: 100K; POT-ALPHA9
POWER: CON10L
R1, R2: 10R; 0207/9
R3, R21: 4.7K; 0207/9
R4, R5, R6, R7, R9, R13, R37, R38, R39, R40, R41, R42, R43, R44, R45, R49, R50, R62: 27K; 0207/9
R8, R11, R12, R54, R55, R56, R57, R58, R59, R60, R61, R64: 100K; 0207/9
R10, R30, R31, R32, R33, R34, R35, R36, R46, R47, R48, R51, R52, R53: 1M; 0207/9
R14, R15, R16, R17, R18, R19, R20, R22, R23, R24, R25, R26, R27, R28, R29, R66: 2.2K; 0207/9
R65: 1K; 0207/9
R-IN: ERTHENVAR_3.5MM_JACKSLOTS; ERTHENVAR-SLOTS
S1: SPDT on-off-on; SPDT-HORIZONTAL-TOP-SUBMINI-MULTICOMP

Connections:
0V: C1.2, C2.1, C3.-, C4.+, C5.-, C8.1, C9.1, C10.2, C11.1, C12.2, C13.1, C14.2, C15.1, C16.1, C17.1, C18.1, C19.1, C20.1, C21.1, C26.1, C27.1, C28.2, CV/CLK-IN.RING1B (SLEEVE), CV/CLK-IN.RING1T (SLEEVE), CV/CLK-IN.RING2H (SLEEVE), D3.1 (-), EXPAND-16STEP.1, EXPAND-16STEP.2, EXPAND-16STEP.8, EXPAND-16STEP.9, EXPAND-16STEP.10, EXPAND-CHANNEL.1, EXPAND-CHANNEL.2, EXPAND-CHANNEL.8, EXPAND-CHANNEL.9, EXPAND-CHANNEL.10, IC1.3 (+IN), IC1.5 (+IN), IC2.12 (V-), IC3.12 (V-), IC4.4 (V-), IC5.8 (VSS), IC5.10 (D0), IC6.3, IC6.5 (CIN), IC6.8 (VSS), IC7.8 (GND), IC9.7 (VEE), IC9.8 (GND), IC10.8 (VSS), IC10.14 (I), IC11.3 (+IN), OUT.RING1B (SLEEVE), OUT.RING1T (SLEEVE), OUT.RING2H (SLEEVE), PCB1-CON1.2, PCB1-CON2.6, PCB2-CON1.2, PCB2-CON2.6, POT1.GND$1 (HOUSING), POT1.GND$2 (HOUSING), POT2.GND$1 (HOUSING), POT2.GND$2 (HOUSING), POT3.GND$1 (HOUSING), POT3.GND$2 (HOUSING), POT4.GND$1 (HOUSING), POT4.GND$2 (HOUSING), POT5.GND$1 (HOUSING), POT5.GND$2 (HOUSING), POT6.GND$1 (HOUSING), POT6.GND$2 (HOUSING), POT7.GND$1 (HOUSING), POT7.GND$2 (HOUSING), POT8.GND$1 (HOUSING), POT8.GND$2 (HOUSING), POWER.3, POWER.4, POWER.5, POWER.6, POWER.7, POWER.8, R9.2, R10.1, R11.1, R12.1, R21.2, R22.2, R46.1, R51.1, R52.1, R53.1, R56.2, R57.2, R58.2, R60.2, R66.1, R-IN.RING1B (SLEEVE), R-IN.RING1T (SLEEVE), R-IN.RING2H (SLEEVE)
5V_REF: C21.2, PCB2-CON2.8, R29.1
+5V: C7.1, IC1.7 (OUT), PCB1-CON2.8, POT1.RIGHT, POT2.RIGHT, POT3.RIGHT, POT4.RIGHT, POT5.RIGHT, POT6.RIGHT, POT7.RIGHT, POT8.RIGHT, R7.2
+12V: C1.1, C3.+, C8.2, C9.2, C11.2, C13.2, C15.2, C16.2, C17.2, C18.2, C19.2, C20.2, C26.2, C27.2, IC1.8 (V+), IC2.3 (V+), IC3.3 (V+), IC4.8 (V+), IC5.16 (VDD), IC6.16 (VDD), IC7.16 (VCC), IC8.8 (V+), IC9.3 (X), IC9.16 (VCC), IC10.1 (VDD), IC11.8 (V+), PCB1-CON2.7, PCB2-CON2.7, R1.2, R3.2, R8.2, R39.2, R40.2, R41.2, R42.2, R43.2, R44.2, R45.2, R49.2, R50.2, R54.2, R55.2, R62.2
-5V: C6.1, C14.1, IC1.1 (OUT), IC7.7 (VEE), POT1.LEFT, POT2.LEFT, POT3.LEFT, POT4.LEFT, POT5.LEFT, POT6.LEFT, POT7.LEFT, POT8.LEFT, R5.2, R6.2
-12V: C2.2, C4.-, C10.1, C12.1, C28.1, IC1.4 (V-), IC8.4 (V-), IC11.4 (V-), PCB1-CON2.5, PCB2-CON2.5, R2.2
BUS_A1: C22.2, IC7.11 (A), IC9.11 (A), PCB1-CON1.3
BUS_A2: IC6.6 (Q0), IC10.3 (I), PCB2-CON1.3
BUS_B1: C23.2, IC7.10 (B), IC9.10 (B), PCB1-CON1.4
BUS_B2: IC6.11 (Q1), IC10.5 (I), PCB2-CON1.4
BUS_C1: C24.2, IC7.9 (C), IC9.9 (C), PCB1-CON1.5
BUS_C2: IC6.14 (Q2), IC10.7 (I), PCB2-CON1.5
COMP_REF_1: IC4.2 (-IN), IC4.6 (-IN), PCB1-CON1.1, R8.1, R9.1
COMP_REF_2: IC3.10 (-IN), PCB2-CON1.1
CV/CLK-IN: EXPAND-16STEP.3, IC8.6 (-IN), IC8.7 (OUT)
CV/CLOCK-FROM-EXP: EXPAND-16STEP.4, IC8.3 (+IN)
CV/CLOCK-IN1: CV/CLK-IN.TIPB (TIP), CV/CLK-IN.TIPT (TIP), PCB1-CON2.3, R11.2
CV/CLOCK-IN2: PCB2-CON2.3, R13.1
DISABLE1: IC7.6 (INH), IC9.6 (INH), PCB1-CON2.1
DISABLE2: EXPAND-16STEP.7, IC10.11 (I), PCB2-CON2.1, R46.2
unnamed: D4.CATHODE (C), IC8.2 (-IN), R14.1, R15.1, R16.1, R17.1, R18.1, R19.1, R20.1, R21.1, R37.1
unnamed: C25.2, IC11.6 (-IN), R64.1
unnamed: R12.2, R38.1, R-IN.TIPB (TIP), R-IN.TIPT (TIP)
unnamed: D4.ANODE (A), IC8.1 (OUT)
unnamed: C7.2, IC1.6 (-IN), R6.1, R7.1
unnamed: IC8.5 (+IN), R13.2
unnamed: IC3.11 (+IN), R37.2, R47.1
unnamed: D8.ANODE (A), D10.ANODE (A), D12.ANODE (A), R59.1
unnamed: IC4.3 (+IN), R38.2, R48.1
unnamed: IC5.5 (EIN), R54.1
unnamed: D5.ANODE (A), IC4.1 (OUT), R48.2, R50.1
unnamed: L1.K (C), L2.K (C), L3.K (C), L4.K (C), L5.K (C), L6.K (C), L7.K (C), L8.K (C), R66.2
unnamed: IC2.2 (OUT), IC5.11 (D1), R30.2, R39.1
unnamed: IC3.13 (OUT), IC6.15 (CLK), R47.2, R49.1
unnamed: IC7.4 (X7), POT8.MID
unnamed: IC7.2 (X6), POT7.MID
unnamed: IC7.5 (X5), POT6.MID
unnamed: IC7.1 (X4), POT5.MID
unnamed: IC7.12 (X3), POT4.MID
unnamed: IC7.15 (X2), POT3.MID
unnamed: IC7.14 (X1), POT2.MID
unnamed: IC7.13 (X0), POT1.MID
unnamed: IC2.5 (+IN), R14.2, R30.1
unnamed: D1.A, POWER.9, POWER.10
unnamed: D1.C, R1.1
unnamed: D2.A, R2.1
unnamed: R55.1, S1.2
unnamed: C6.2, IC1.2 (-IN), R4.1, R5.1
unnamed: D2.C, POWER.1, POWER.2
unnamed: IC2.4 (-IN), R22.1, R23.2
unnamed: IC2.1 (OUT), IC5.12 (D2), R31.2, R40.1
unnamed: IC2.7 (+IN), R15.2, R31.1
unnamed: IC2.6 (-IN), R23.1, R24.2
unnamed: C5.+, D3.2 (+), R3.1, R4.2
unnamed: IC2.14 (OUT), IC5.13 (D3), R32.2, R41.1
unnamed: IC2.9 (+IN), R16.2, R32.1
unnamed: IC7.3 (X), IC11.5 (+IN)
unnamed: C22.1, D7.ANODE (A), D8.CATHODE (C), R56.1
unnamed: IC2.8 (-IN), R24.1, R25.2
unnamed: IC2.13 (OUT), IC5.1 (D4), R33.2, R42.1
unnamed: IC2.11 (+IN), R17.2, R33.1
unnamed: IC2.10 (-IN), R25.1, R26.2
unnamed: C23.1, D9.ANODE (A), D10.CATHODE (C), R57.1
unnamed: IC3.2 (OUT), IC5.2 (D5), R34.2, R43.1
unnamed: IC3.5 (+IN), R18.2, R34.1
unnamed: IC3.4 (-IN), R26.1, R27.2
unnamed: C24.1, D11.ANODE (A), D12.CATHODE (C), R58.1
unnamed: IC3.1 (OUT), IC5.3 (D6), R35.2, R44.1
unnamed: IC3.7 (+IN), R19.2, R35.1
unnamed: D13.ANODE (A), IC11.1 (OUT)
unnamed: IC3.6 (-IN), R27.1, R28.2
unnamed: IC3.14 (OUT), IC5.4 (D7), R36.2, R45.1
unnamed: IC3.9 (+IN), R20.2, R36.1
unnamed: IC3.8 (-IN), R28.1, R29.2
unnamed: IC11.2 (-IN), R59.2, R61.1
unnamed: D7.CATHODE (C), D9.CATHODE (C), D11.CATHODE (C), D13.CATHODE (C), IC4.5 (+IN), R60.1, R61.2
unnamed: EXPAND-CHANNEL.4, IC10.2 (O)
unnamed: EXPAND-CHANNEL.6, IC10.6 (O)
unnamed: EXPAND-CHANNEL.5, IC10.4 (O)
unnamed: EXPAND-CHANNEL.3, IC10.10 (O)
unnamed: EXPAND-CHANNEL.7, IC10.12 (O)
unnamed: C25.1, IC11.7 (OUT), R65.1
OUT1: OUT.TIPB (TIP), OUT.TIPT (TIP), PCB1-CON2.2, R64.2, R65.2
OUT2: EXPAND-16STEP.5, PCB2-CON2.2
PE1: PCB1-CON1.8, R52.2, S1.1
PE2: IC6.1 (PE), PCB2-CON1.8
PRESET_A: IC5.9 (Q0), IC6.4 (P0)
PRESET_B: IC5.7 (Q1), IC6.12 (P1)
PRESET_C: IC5.6 (Q2), IC6.13 (P2)
RESET1: D5.CATHODE (C), PCB1-CON1.6, R53.2
RESET2: D6.CATHODE (C), IC6.9 (RES), PCB2-CON1.6
RESET-EXP: D6.ANODE (A), EXPAND-16STEP.6, R10.2
STEP1: IC9.13 (X0), L1.A
STEP2: IC9.14 (X1), L2.A
STEP3: IC9.15 (X2), L3.A
STEP4: IC9.12 (X3), L4.A
STEP5: IC9.1 (X4), L5.A
STEP6: IC9.5 (X5), L6.A
STEP7: IC9.2 (X6), L7.A
STEP8: IC9.4 (X7), L8.A
TRIGS1: IC4.7 (OUT), PCB1-CON2.4, R62.1
TRIGS2: IC10.9 (I), PCB2-CON2.4
U/D1: PCB1-CON1.7, R51.2, S1.3
U/D2: IC6.10 (U/!D), PCB2-CON1.7

Notes on the sheet:
Roll Your Own VC Sequencer v1.5 TH ljunggrenaudio.com 2015

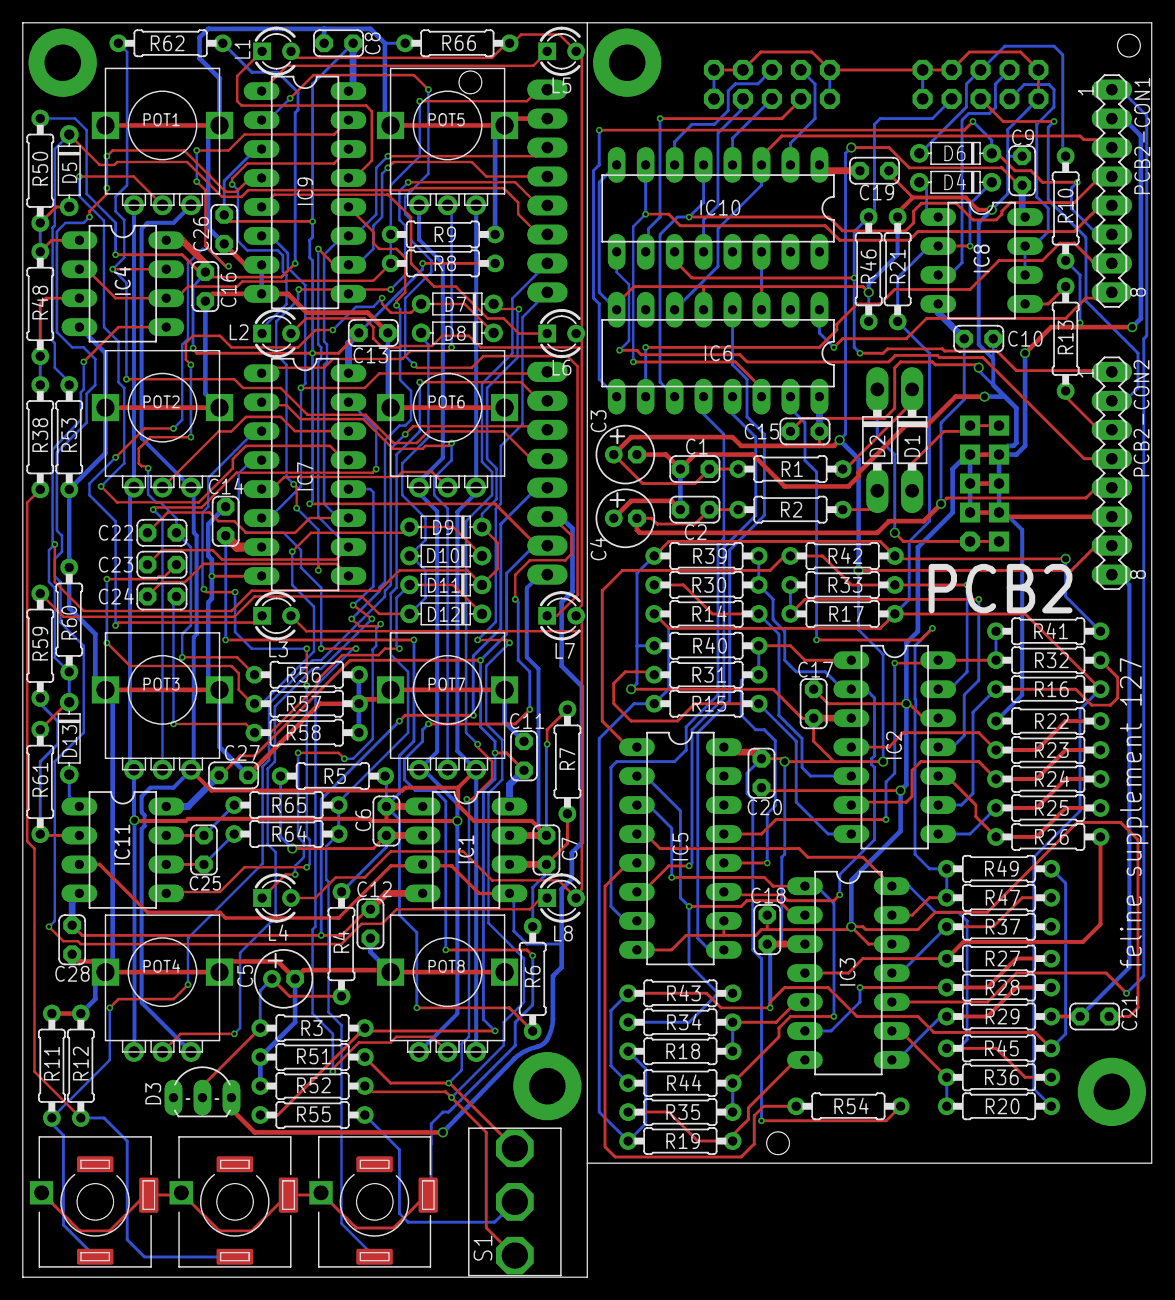
[picture p39: board PCB 1.5 TH.brd from above]

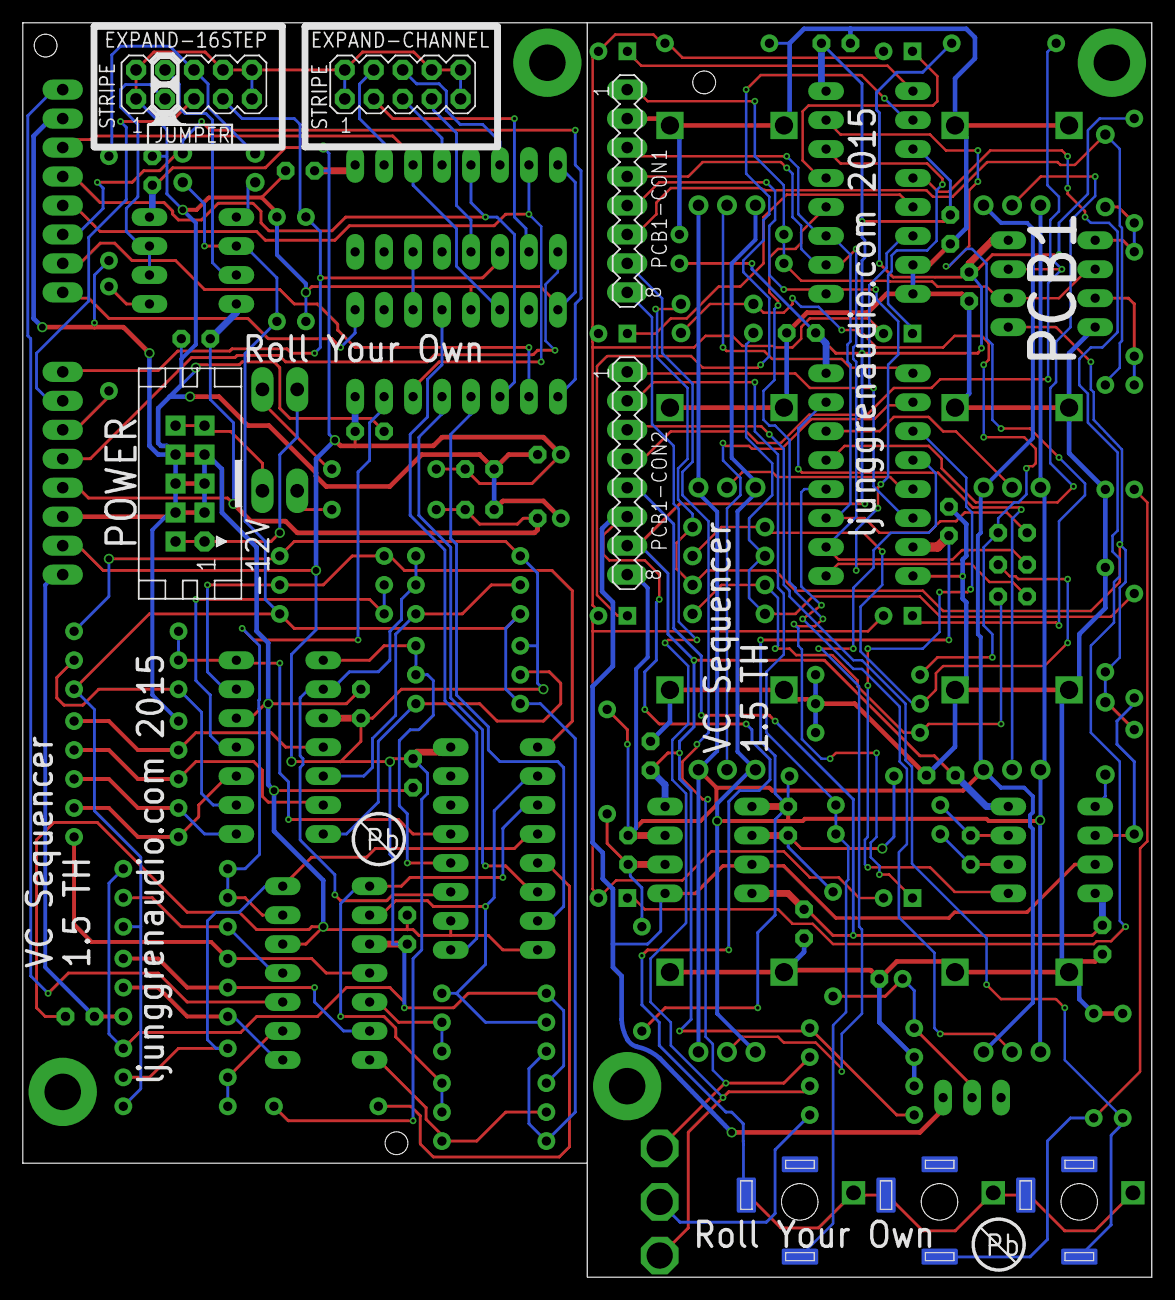
[picture p40: board PCB 1.5 TH.brd from below]

Board: 2 copper layers, 99.0 x 110.0 mm, 144 parts (5 on the bottom side), 104 nets.
